kiranduriseti/HID_controller_PCB/STM32_HID_controller/bom-JLCPCB Assembly Order Final.xls

JLCPCB BOM Tool - BOM Matching
BOM name：bom-JLCPCB Assembly Order.xlsx |  |  | Download Time：2026-09-28 13:52:42 |  |  |  | * Our matching results are updated in real-time, but stock and prices may change. If it's been over 24 hours, please re-match before placing your order.
PCB Assembled Qty：5 |  |  | Est. Total Price：50.8586
Your BOM |  |  |  | Matched Parts |  |  |  |  |  |  | Order Information
Designator | Comment | Footprint | JLCPCB Part # | Matches | Part # | Manufacturer | Footprint | Description | Category | Warning | JLCPCB Part # | Product link | Lib Type | Qty | Source | Total Price ($)
C1,C10,C2,C22,C3,C4,C5,C7 | 100n | 0402 |  | Select by Customer | CL05B104KO5NNNC | Samsung Electro-Mechanics | 0402 | 100nF 16V X7R ±10% 0402 Multilayer Ceramic Capacitors MLCC - SMD/SMT ROHS | Multilayer Ceramic Capacitors MLCC - SMD/SMT | 1.The comment (CL05B104KO5NNNC) of this part does not match the one (100n) provided in your BOM. Please confirm; | C1525 | https://jlcpcb.com/partdetail/1877-CL05B104KO5NNNC/C1525 | Basic | 26 | 26 JLCPCB | 0.117
C6 | 10u | 0603 |  | Select by Customer | TCC0603X5R106K100CT | CCTC | 0603 | 10V 10uF X5R ±10% 0603 Multilayer Ceramic Capacitors MLCC - SMD/SMT ROHS | Multilayer Ceramic Capacitors MLCC - SMD/SMT | 1.The comment (TCC0603X5R106K100CT) of this part does not match the one (10u) provided in your BOM. Please confirm; | C380314 | https://jlcpcb.com/partdetail/CCTC-TCC0603X5R106K100CT/C380314 | Extended | 20 | 20 JLCPCB | 0.768
C8,C9 | 1u | 0402 |  | Select by Customer | CL05A105KA5NQNC | Samsung Electro-Mechanics | 0402 | 1uF 25V X5R ±10% 0402 Multilayer Ceramic Capacitors MLCC - SMD/SMT ROHS | Multilayer Ceramic Capacitors MLCC - SMD/SMT | 1.The comment (CL05A105KA5NQNC) of this part does not match the one (1u) provided in your BOM. Please confirm; | C52923 | https://jlcpcb.com/partdetail/53938-CL05A105KA5NQNC/C52923 | Basic | 20 | 20 JLCPCB | 0.198
C11,C12 | 10p | 0402 |  | Select by Customer | CL05C100JB5NNNC | Samsung Electro-Mechanics | 0402 | 10pF 50V C0G ±5% 0402 Multilayer Ceramic Capacitors MLCC - SMD/SMT ROHS | Multilayer Ceramic Capacitors MLCC - SMD/SMT | 1.The comment (CL05C100JB5NNNC) of this part does not match the one (10p) provided in your BOM. Please confirm; | C32949 | https://jlcpcb.com/partdetail/33914-CL05C100JB5NNNC/C32949 | Basic | 20 | 20 JLCPCB | 0.114
C13 | 22u | 0805 |  | Select by Customer | TCC0805X5R226K160FT | CCTC | 0805 | 16V 22uF ±10% 0805 Multilayer Ceramic Capacitors MLCC - SMD/SMT ROHS |  | 1.The comment (TCC0805X5R226K160FT) of this part does not match the one (22u) provided in your BOM. Please confirm; | C48885730 | https://jlcpcb.com/partdetail/CCTC-TCC0805X5R226K160FT/C48885730 | Extended | 6 | 6 JLCPCB | 0.7932
C14 | 10u | 0805 |  | Select by Customer | HGC0805R5106K250NSLJ | Chinocera | 0805 | 10uF 25V X5R ±10% 0805 Multilayer Ceramic Capacitors MLCC - SMD/SMT ROHS | Multilayer Ceramic Capacitors MLCC - SMD/SMT | 1.The comment (HGC0805R5106K250NSLJ) of this part does not match the one (10u) provided in your BOM. Please confirm; | C19103847 | https://jlcpcb.com/partdetail/Chinocera-HGC0805R5106K250NSLJ/C19103847 | Extended | 20 | 20 JLCPCB | 0.908
C15,C16,C17,C18,C23 | 10n | 0402 |  | Select by Customer | CL05B103KB5NNNC | Samsung Electro-Mechanics | 0402 | 10nF 50V X7R ±10% 0402 Multilayer Ceramic Capacitors MLCC - SMD/SMT ROHS | Multilayer Ceramic Capacitors MLCC - SMD/SMT | 1.The comment (CL05B103KB5NNNC) of this part does not match the one (10n) provided in your BOM. Please confirm; | C15195 | https://jlcpcb.com/partdetail/15869-CL05B103KB5NNNC/C15195 | Basic | 20 | 20 JLCPCB | 0.1
C21 | 4.7u | 0603 |  | Select by Customer | CL10A475KP8NNNC | Samsung Electro-Mechanics | 0603 | 10V 4.7uF X5R ±10% 0603 Multilayer Ceramic Capacitors MLCC - SMD/SMT ROHS | Multilayer Ceramic Capacitors MLCC - SMD/SMT | 1.The comment (CL10A475KP8NNNC) of this part does not match the one (4.7u) provided in your BOM. Please confirm; | C1705 | https://jlcpcb.com/partdetail/2057-CL10A475KP8NNNC/C1705 | Extended | 20 | 20 JLCPCB | 0.324
C24 | 2.2u | 0201 |  | Select by Customer | GRM033R60J225ME47D | Murata Electronics | 0201 | 2.2uF 6.3V X5R ±20% 0201 Multilayer Ceramic Capacitors MLCC - SMD/SMT ROHS | Multilayer Ceramic Capacitors MLCC - SMD/SMT | 1.The comment (GRM033R60J225ME47D) of this part does not match the one (2.2u) provided in your BOM. Please confirm; | C76933 | https://jlcpcb.com/partdetail/MurataElectronics-GRM033R60J225ME47D/C76933 | Extended | 20 | 20 JLCPCB | 0.54
D1 | RED | 0603 |  | Select by Customer | XL-1608SURC-06 | XINGLIGHT | 0603 | -40℃~+85℃ 120° 2.3V 20mA 225mcd 50mW 620nm~630nm 625nm Discrete Diode Red Top-mount Water Clear 0603 LED Indication - Discrete ROHS | LED Indication - Discrete |  | C965799 | https://jlcpcb.com/partdetail/XINGLIGHT-XL_1608SURC06/C965799 | Extended | 20 | 20 JLCPCB | 0.076
FB1 | 120R | 0603 |  | Select by Customer | BLM18AG121SN1D | Murata Electronics | 0603 | -55℃~+125℃ 1 120Ω@100MHz 180mΩ 800mA ±25% 0603 Ferrite Beads ROHS | Ferrite Beads |  | C76892 | https://jlcpcb.com/partdetail/MurataElectronics-BLM18AG121SN1D/C76892 | Extended | 20 | 20 JLCPCB | 0.25
J1 | USB_B_Micro | USB_Micro-B_Wuerth_629105150521 |  | Select by Customer | 629105150521 | Wurth Elektronik | SMD | -40℃~+85℃ 1 1A、3A 30V 5P Black Female Micro-B USB 2.0 SMD USB Connectors ROHS | USB Connectors |  | C2894326 | https://jlcpcb.com/partdetail/WurthElektronik-629105150521/C2894326 | Extended | 2 | 2 JLCPCB | 6.236
J2 | Conn_01x04_Pin | PinHeader_1x04_P2.54mm_Vertical |  | Select by Customer | PZ2.54-1x4-11.2 | ZHOURI | 插件,P=2.54mm | -45℃~+105℃ 1 1x4P 2.54mm 2.54mm 2.5A 3mm 4P 5.7mm Brass Gold Square pin Through Hole Plugin,P=2.54mm Pin Headers ROHS | Pin Headers |  | C29779969 | https://jlcpcb.com/partdetail/ZHOURI-PZ2_54_1x4_112/C29779969 | Extended | 3 | 3 JLCPCB | 0.0756
J3,J5 | Conn_01x03_Pin | JST_EH_S3B-EH_1x03_P2.50mm_Horizontal |  | Select by Customer | S3B-EH(LF)(SN) | JST | 弯插,P=2.5mm | -25℃~+85℃ 1 10mm 1x3P 2.5mm 250V 3 3A 3P 4.2mm 8.2mm Brass EH K Pin PA66 Right Angle Tin UL94V-0 White 弯插,P=2.5mm Wire To Board Connector ROHS | Wire To Board Connector |  | C263754 | https://jlcpcb.com/partdetail/JST-S3B_EH_LF_SN/C263754 | Extended | 5 | 5 JLCPCB | 0.282
R1 | 10k | 0402 |  | Select by Customer | RC0402FR-0710KL | YAGEO | 0402 | -55℃~+155℃ 10kΩ 50V 62.5mW Thick Film Resistor ±1% ±100ppm/℃ 0402 Chip Resistor - Surface Mount ROHS | Chip Resistor - Surface Mount | 1.The comment (RC0402FR-0710KL) of this part does not match the one (10k) provided in your BOM. Please confirm; | C60490 | https://jlcpcb.com/partdetail/YAGEO-RC0402FR0710KL/C60490 | Extended | 20 | 20 JLCPCB | 0.046
R2 | 1.5k | 0402 |  | Select by Customer | CRCW04021K50FKED | Vishay Intertech | 0402 | -55℃~+155℃ 1.5kΩ 63mW Thick Film Resistor ±1% ±100ppm/℃ 0402 Chip Resistor - Surface Mount ROHS | Others | 1.The comment (CRCW04021K50FKED) of this part does not match the one (1.5k) provided in your BOM. Please confirm; | C71622 | https://jlcpcb.com/partdetail/VishayIntertech-CRCW04021K50FKED/C71622 | Extended | 20 | 20 JLCPCB | 0.132
R3,R4 | 4.7k | 0402 |  | Select by Customer | SCR0402F4K7 | VO | 0402 | -55℃~+155℃ 4.7kΩ 50V 62.5mW Thick Film Resistor ±1% ±100ppm/℃ 0402 Chip Resistor - Surface Mount ROHS | Chip Resistor - Surface Mount | 1.The comment (SCR0402F4K7) of this part does not match the one (4.7k) provided in your BOM. Please confirm; | C3015810 | https://jlcpcb.com/partdetail/VO-SCR0402F4K7/C3015810 | Extended | 20 | 20 JLCPCB | 0.01
SW1 | SW_SPDT | SW_SPDT_PCM12 |  | Select by Customer | PCM12SMTR | C&K | SMD | -20℃~+85℃ 6V PC Pin Rectangular Columnar SPDT Surface Mount,Vertical SMD Slide Switches ROHS | Slide Switches |  | C221841 | https://jlcpcb.com/partdetail/CK-PCM12SMTR/C221841 | Extended | 2 | 2 JLCPCB | 3.563
SW6,SW7,SW8,SW9 | SW_Push | SW_PUSH-12mm_Wuerth-430476085716 |  | Select by Customer | B3F-4055 | Omron Electronics | 插件-4P,12x12mm | -25℃~+70℃ 1,000,000 cycles 12mm 12mm 2.6N 24V 50mA 7.3mm PC Pin Rectangular Button SPST-NO Through Hole 插件-4P,12x12mm Tactile Switches ROHS | Tactile Switches |  | C84931 | https://jlcpcb.com/partdetail/OmronElectronics-B3F4055/C84931 | Extended | 8 | 8 JLCPCB | 1.0264
SW10,SW11,SW14,SW2,SW3 | SW_Push | SW_PUSH_6mm |  | Select by Customer | B3F-1000 | Omron Electronics | 插件-4P,6x6mm | -25℃~+70℃ 1,000,000 cycles 1N 24V 4.3mm 50mA 6mm 6mm PC Pin Round Button SPST-NO Through Hole 插件-4P,6x6mm Tactile Switches ROHS | Tactile Switches |  | C93157 | https://jlcpcb.com/partdetail/OmronElectronics-B3F1000/C93157 | Extended | 11 | 11 JLCPCB | 1.8832
U1 | STM32F446RETx | LQFP-64_10x10mm_P0.5mm |  | Select by Customer | STM32F446RET6 | STMicroelectronics | LQFP-64(10x10) | -40℃~+85℃ 1.7V~3.6V 128KB 12bit 12bit 180MHz 32 Bit 50 512KB ARM Cortex-M4 Built-in FLASH LQFP-64(10x10) Microcontrollers (MCU/MPU/SOC) ROHS | Microcontrollers (MCU/MPU/SOC) |  | C69336 | https://jlcpcb.com/partdetail/STMicroelectronics-STM32F446RET6/C69336 | Extended | 2 | 2 JLCPCB | 24.6806
U2 | TLV1117-33 | SOT-223-3_TabPin2 |  | Select by Customer | TLV1117LV33DCYR | Texas Instruments | SOT-223 | -40℃~+125℃@(Tj) 1 100uA 1A 3.3V 455mV@(1A) 5.5V 60uVrms 65dB@(1kHz) Fixed Positive Under Voltage Lockout、Over Current Protection、Over Temperature Protection SOT-223 Voltage Regulators - Linear, Low Drop Out (LDO) Regulators ROHS | Voltage Regulators - Linear, Low Drop Out (LDO) Regulators |  | C15578 | https://jlcpcb.com/partdetail/TexasInstruments-TLV1117LV33DCYR/C15578 | Extended | 5 | 5 JLCPCB | 1.965
U3 | USBLC6-2SC6 | SOT-23-6 |  | Select by Customer | USBLC6-2SC6 | STMicroelectronics | SOT-23-6L | -40℃~+125℃ 150nA 17V 2 3.5pF 5.25V 5A 6V ESD IEC 61000-4-2 Unidirectional SOT-23-6L ESD and Surge Protection (TVS/ESD) ROHS | ESD And Surge Protection (TVS/ESD) |  | C7519 | https://jlcpcb.com/partdetail/STMicroelectronics-USBLC62SC6/C7519 | Extended | 5 | 5 JLCPCB | 0.8825
U4 | joystick_right | XDCR_COM-09032 |  | Select by Customer | RKJXV1224005 | ALPSALPINE | 插件,13x13mm | 插件,13x13mm Multi-Directional Switches ROHS | Multi-Directional Switches | 1.Multiple lines in the BOM have been matched to the same part. Please check if the matching is correct. ; | C146170 | https://jlcpcb.com/partdetail/ALPSALPINE-RKJXV1224005/C146170 | Extended | 0 | 0 JLCPCB | 0
U5 | joystick_left | XDCR_COM-09032 |  | Select by Customer | RKJXV1224005 | ALPSALPINE | 插件,13x13mm | 插件,13x13mm Multi-Directional Switches ROHS | Multi-Directional Switches | 1.Multiple lines in the BOM have been matched to the same part. Please check if the matching is correct. ; | C146170 | https://jlcpcb.com/partdetail/ALPSALPINE-RKJXV1224005/C146170 | Extended | 0 | 0 JLCPCB | 0
U7 | ICM-42670-P | LGA14_2.5X3X0.76_IVS-M |  | Select by Customer | ICM-42670-P | TDK InvenSense | LGA-14(2.5x3) | -40℃~+85℃ 1.71V~3.6V 16bit 2.25KB 3.5uA Accelerometer Gyroscope SPI、I2C、I3C X,Y,Z X,Y,Z ±16g ±2000dps LGA-14(2.5x3) Accelerometers ROHS | Accelerometers |  | C3288646 | https://jlcpcb.com/partdetail/TDKInvenSense-ICM_42670P/C3288646 | Extended | 2 | 2 JLCPCB | 4.5536
Y1 | 8MHz | Crystal_SMD_3225-4Pin_3.2x2.5mm |  | Select by Customer | 3225-8.00-8-10-10/A | Suzhou Liming Elec | SMD3225-4P | -20℃~+70℃ 8MHz 8pF Crystal Oscillator ±10ppm ±20ppm SMD3225-4P Crystals ROHS | Crystals |  | C518135 | https://jlcpcb.com/partdetail/534672-3225_8_00_8_10_10A/C518135 | Extended | 5 | 5 JLCPCB | 1.3345
