kiranduriseti/HID_controller_PCB/STM32_HID_controller_shoulder/bom-JLCPCB Assembly Order Final.xls

JLCPCB BOM Tool - BOM Matching
BOM name：bom-JLCPCB Assembly Order.xlsx |  |  | Download Time：2026-09-28 14:10:01 |  |  |  | * Our matching results are updated in real-time, but stock and prices may change. If it's been over 24 hours, please re-match before placing your order.
PCB Assembled Qty：5 |  |  | Est. Total Price：1.3828
Your BOM |  |  |  | Matched Parts |  |  |  |  |  |  | Order Information
Designator | Comment | Footprint | JLCPCB Part # | Matches | Part # | Manufacturer | Footprint | Description | Category | Warning | JLCPCB Part # | Product link | Lib Type | Qty | Source | Total Price ($)
J4 | Conn_01x03_Socket | JST_EH_S3B-EH_1x03_P2.50mm_Horizontal |  | Select by Customer | S3B-EH(LF)(SN) | JST | 弯插,P=2.5mm | -25℃~+85℃ 1 10mm 1x3P 2.5mm 250V 3 3A 3P 4.2mm 8.2mm Brass EH K Pin PA66 Right Angle Tin UL94V-0 White 弯插,P=2.5mm Wire To Board Connector ROHS | Wire To Board Connector |  | C263754 | https://jlcpcb.com/partdetail/JST-S3B_EH_LF_SN/C263754 | Extended | 3 | 3 JLCPCB | 0.1692
SHOULDER1 | SW_Push | SW_PUSH-12mm_Wuerth-430476085716 |  | Select by Customer | B3F-4055 | Omron Electronics | 插件-4P,12x12mm | -25℃~+70℃ 1,000,000 cycles 12mm 12mm 2.6N 24V 50mA 7.3mm PC Pin Rectangular Button SPST-NO Through Hole 插件-4P,12x12mm Tactile Switches ROHS | Tactile Switches |  | C84931 | https://jlcpcb.com/partdetail/OmronElectronics-B3F4055/C84931 | Extended | 2 | 2 JLCPCB | 0.2566
TRIGGER1 | SW_Push | SW_DIP_SPSTx01_Piano_10.8x4.1mm_W7.62mm_P2.54mm |  | Select by Customer | DS1040-01RT | CONNFLY Elec | 插件,P=2.54mm | -40℃~+85℃ 1 2.54mm PC Pin Red SPST 插件,P=2.54mm DIP Switches ROHS | DIP Switches |  | C3024979 | https://jlcpcb.com/partdetail/CONNFLYElec-DS104001RT/C3024979 | Extended | 3 | 3 JLCPCB | 0.957
