kiranduriseti/HID_controller_PCB/STM32_HID_controller_shoulder/production/bom.csv

Designator | Footprint | Quantity | Value | LCSC Part #
J4 | JST_EH_S3B-EH_1x03_P2.50mm_Horizontal | 1 | Conn_01x03_Socket
SHOULDER1 | SW_PUSH-12mm_Wuerth-430476085716 | 1 | SW_Push
TRIGGER1 | SW_DIP_SPSTx01_Piano_10.8x4.1mm_W7.62mm_P2.54mm | 1 | SW_Push
