kiranduriseti/HID_controller_PCB/STM32_HID_controller_shoulder/ADXL345/ADXL345.step

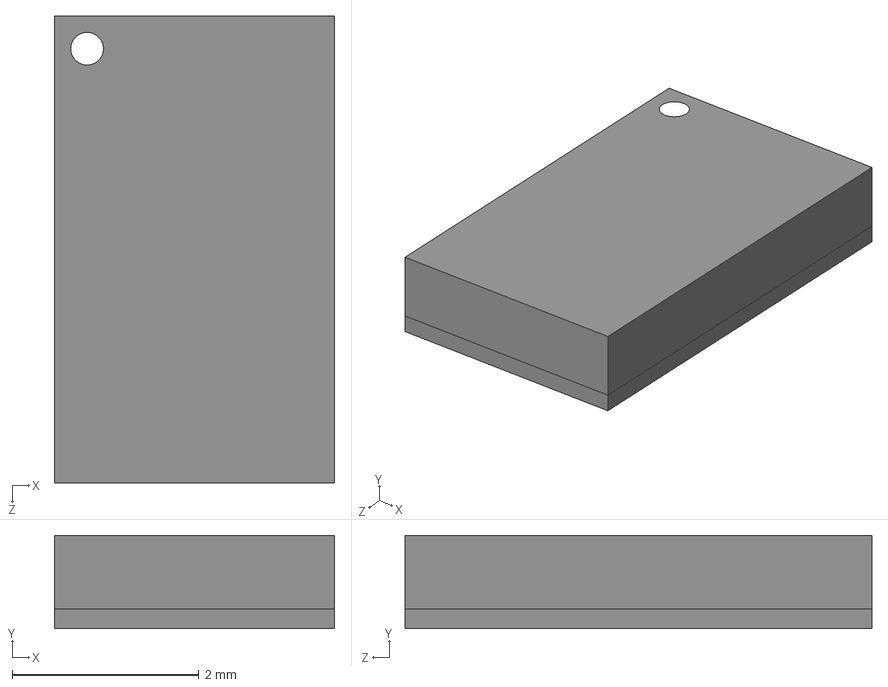
[picture p1: CAD file, 2026-01-08]
STM32_HID_controller_shoulder/ADXL345/ADXL345.step
3.00 x 1.00 x 5.00 mm
