kiranduriseti/HID_controller_PCB/STM32_HID_controller_shoulder/COM-09032/COM-09032.step

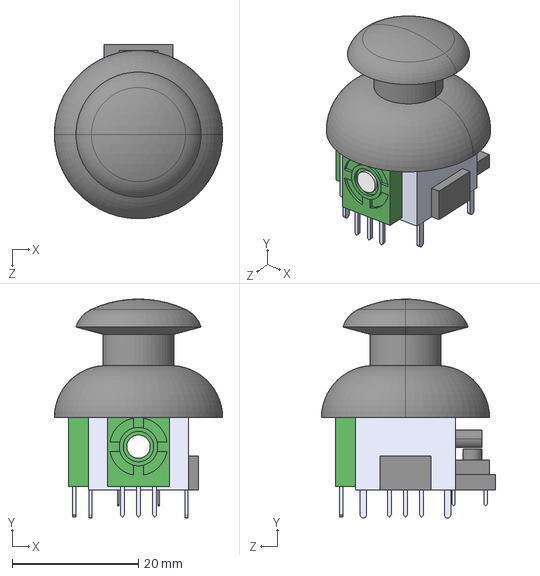
[picture p2: CAD file, 2026-01-08]
STM32_HID_controller_shoulder/COM-09032/COM-09032.step
26.7 x 34.7 x 27.6 mm
