kiranduriseti/HID_controller_PCB/STM32_HID_controller_shoulder/629105150521%20%28rev1%29.stp

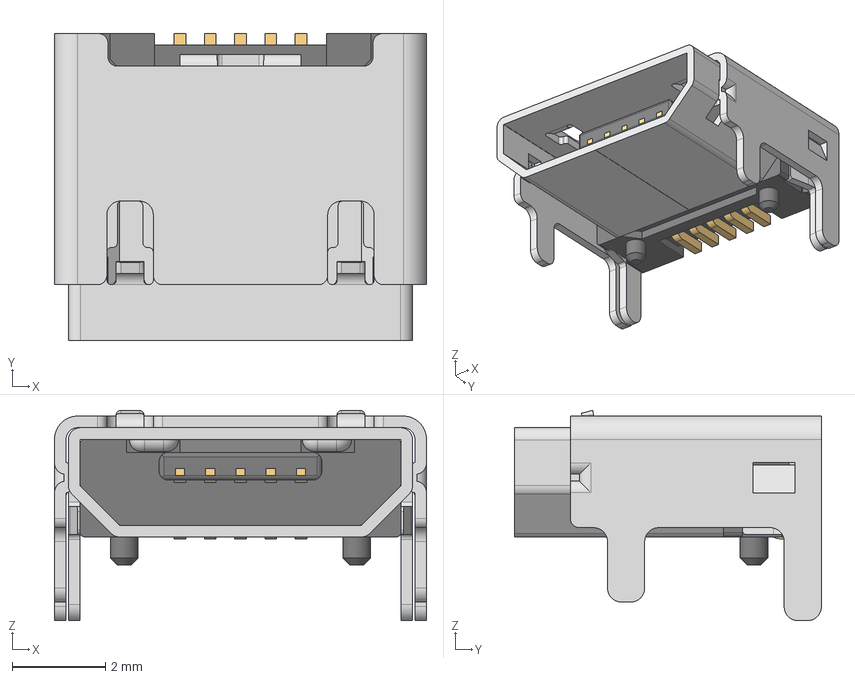
[picture p3: CAD file, 2026-01-08]
STM32_HID_controller_shoulder/629105150521%20%28rev1%29.stp
8.00 x 6.60 x 4.52 mm
629105150521_Housing
629105150521_Pin1 x 4
629105150521_Pin2
629105150521_Shielding2
629105150521_Shielding
