kiranduriseti/HID_controller_PCB/STM32_HID_controller_shoulder/STM32_HID_controller-right.kicad_pcb

## KiCad design STM32_HID_controller_shoulder/STM32_HID_controller-right.kicad_pcb (2026-09-28)

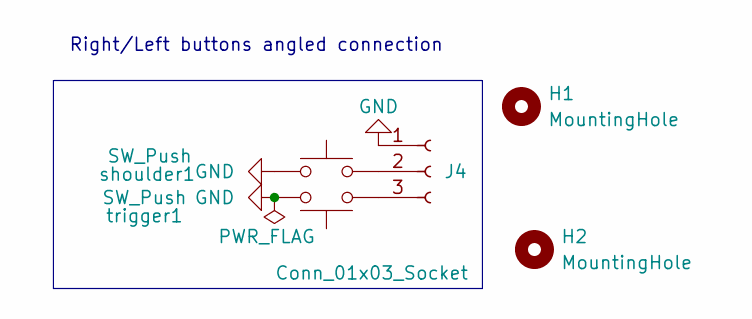
[picture p4: schematic STM32_HID_controller-right.kicad_sch, STM32 HID Controller PCB]

Parts:
H1, H2: MountingHole; MountingHole_2.2mm_M2
J4: Conn_01x03_Socket; JST_EH_S3B-EH_1x03_P2.50mm_Horizontal
shoulder1: SW_Push; SW_PUSH-12mm_Wuerth-430476085716
trigger1: SW_Push; SW_DIP_SPSTx01_Piano_10.8x4.1mm_W7.62mm_P2.54mm

Connections:
GND: J4.1, shoulder1.2, trigger1.1
unnamed: J4.2, shoulder1.1
unnamed: J4.3, trigger1.2

Notes on the sheet:
Right/Left buttons angled connection

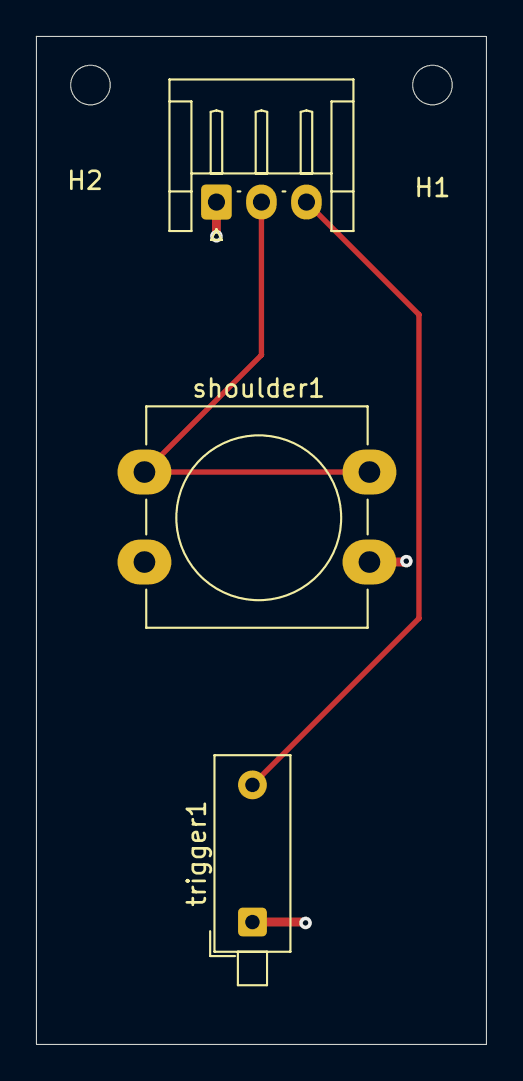
[picture p5: board STM32_HID_controller-right.kicad_pcb from above]

Board: 2 copper layers, 25.0 x 56.0 mm, 5 parts (0 on the bottom side), 3 nets.
