kiranduriseti/HID_controller_PCB/STM32_HID_controller/STM32_HID_controller.kicad_pcb

## KiCad design STM32_HID_controller/STM32_HID_controller.kicad_pcb (2026-09-28)

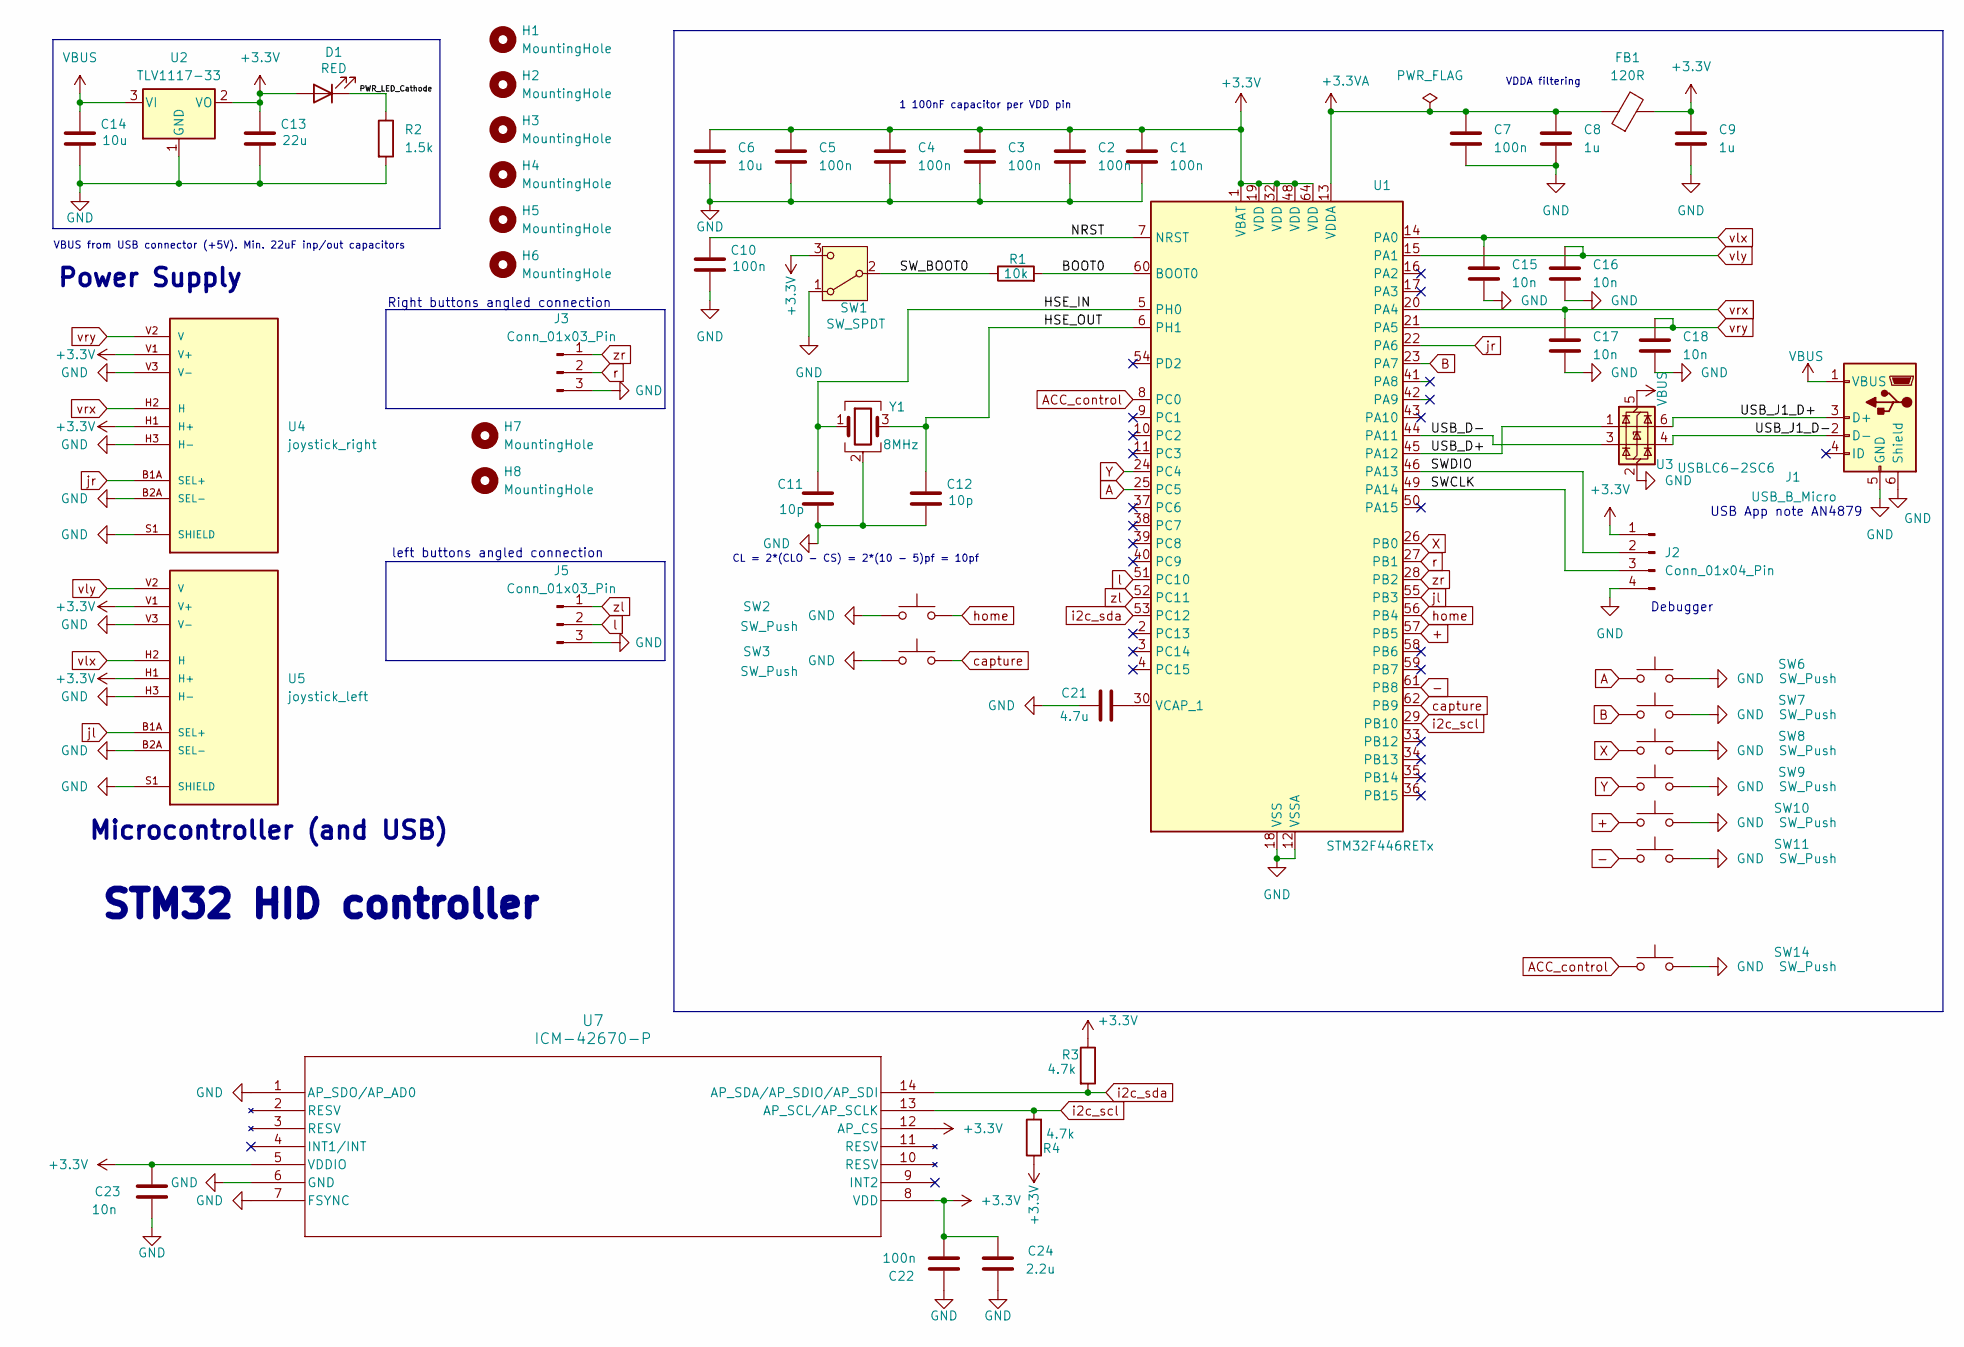
[picture p6: schematic STM32_HID_controller.kicad_sch, STM32 HID Controller PCB]

Parts:
C1, C2, C3, C4, C5, C7, C10, C22: 100n; C_0402_1005Metric; MPN GRM155R71C104KA88D
C6: 10u; C_0603_1608Metric; MPN C1608X5R1A106K080AC
C8, C9: 1u; C_0402_1005Metric; MPN CC0402KRX5R6BB105
C11, C12: 10p; C_0402_1005Metric; MPN GRM1555C1H100JA01D
C13: 22u; C_0805_2012Metric; MPN C0805C226M8PACTU
C14: 10u; C_0805_2012Metric; MPN C0805C106M8PACTU
C15, C16, C17, C18, C23: 10n; C_0402_1005Metric; MPN GRM155R71C103KA01D
C21: 4.7u; C_0603_1608Metric; MPN C0603C475K8PACTU
C24: 2.2u; C_0201_0603Metric; MPN GRM033R60J225ME47D
D1: RED; LED_0603_1608Metric; MPN LTST-C190KRKT
FB1: 120R; L_0603_1608Metric; MPN BLM18AG121SN1D
H1, H3, H7, H8: MountingHole; MountingHole_2.2mm_M2
H2, H4, H5, H6: MountingHole; MountingHole_3.2mm_M3
J1: USB_B_Micro; USB_Micro-B_Wuerth_629105150521; MPN 629105150521
J2: Conn_01x04_Pin; PinHeader_1x04_P2.54mm_Vertical; MPN 61300411121
J3, J5: Conn_01x03_Pin; JST_EH_S3B-EH_1x03_P2.50mm_Horizontal; MPN S3B-EH(LF)(SN)
R1: 10k; R_0402_1005Metric; MPN RC0402FR-0710KL
R2: 1.5k; R_0402_1005Metric; MPN RC0402FR-071K5L
R3, R4: 4.7k; R_0402_1005Metric; MPN RC0402FR-074K7L
SW1: SW_SPDT; SW_SPDT_PCM12; MPN PCM12SMTR
SW2, SW3, SW10, SW11, SW14: SW_Push; SW_PUSH_6mm; MPN B3F-1000
SW6, SW7, SW8, SW9: SW_Push; SW_PUSH-12mm_Wuerth-430476085716; MPN 430476085716
U1: STM32F446RETx; LQFP-64_10x10mm_P0.5mm; MPN STM32F446RET6
U2: TLV1117-33; SOT-223-3_TabPin2; MPN TLV1117LV33DCYR
U3: USBLC6-2SC6; SOT-23-6; MPN USBLC6-2SC6
U4: joystick_right; XDCR_COM-09032; PARTREV N/A
U5: joystick_left; XDCR_COM-09032; PARTREV N/A
U7: ICM-42670-P; LGA14_2.5X3X0.76_IVS-M; MPN ICM-42670-P
Y1: 8MHz; Crystal_SMD_3225-4Pin_3.2x2.5mm; MPN J32SMX-H-F-G-I-8M0

Connections:
+: SW10.1, U1.57 (PB5)
+3.3V: C1.1, C2.1, C3.1, C4.1, C5.1, C6.1, C9.1, C13.1, C22.2, C23.2, C24.1, D1.2 (A), FB1.2, J2.1, R3.1, R4.1, SW1.3 (C), U1.1 (VBAT), U1.19 (VDD), U1.32 (VDD), U1.48 (VDD), U1.64 (VDD), U2.2 (VO), U4.H1 (H+), U4.V1 (V+), U5.H1 (H+), U5.V1 (V+), U7.5 (VDDIO), U7.8 (VDD), U7.12 (AP_CS)
+3.3VA: C7.1, C8.1, FB1.1, U1.13 (VDDA)
-: SW11.1, U1.61 (PB8)
/BOOT0: R1.2, U1.60 (BOOT0)
/HSE_IN: C11.1, U1.5 (PH0), Y1.1
/HSE_OUT: C12.1, U1.6 (PH1), Y1.3
/NRST: C10.1, U1.7 (NRST)
/PWR_LED_Cathode: D1.1 (K), R2.1
/SWCLK: J2.3, U1.49 (PA14)
/SWDIO: J2.2, U1.46 (PA13)
/SW_BOOT0: R1.1, SW1.2 (B)
/USB_D+: U1.45 (PA12), U3.1 (I/O1)
/USB_D-: U1.44 (PA11), U3.3 (I/O2)
/USB_J1_D+: J1.3 (D+), U3.6 (I/O1)
/USB_J1_D-: J1.2 (D-), U3.4 (I/O2)
A: SW6.1, U1.25 (PC5)
ACC_control: SW14.1, U1.8 (PC0)
B: SW7.1, U1.23 (PA7)
GND: C1.2, C2.2, C3.2, C4.2, C5.2, C6.2, C7.2, C8.2, C9.2, C10.2, C11.2, C12.2, C13.2, C14.2, C15.2, C16.2, C17.2, C18.2, C21.1, C22.1, C23.1, C24.2, J1.5 (GND), J1.6 (Shield), J2.4, J3.3, J5.3, R2.2, SW1.1 (A), SW2.1, SW3.1, SW6.2, SW7.2, SW8.2, SW9.2, SW10.2, SW11.2, SW14.2, U1.12 (VSSA), U1.18 (VSS), U1.31 (VSS), U1.47 (VSS), U1.63 (VSS), U2.1 (GND), U3.2 (GND), U4.B2A (SEL-), U4.H3 (H-), U4.S1 (SHIELD), U4.S2 (SHIELD), U4.S3 (SHIELD), U4.S4 (SHIELD), U4.V3 (V-), U5.B2A (SEL-), U5.H3 (H-), U5.S1 (SHIELD), U5.S2 (SHIELD), U5.S3 (SHIELD), U5.S4 (SHIELD), U5.V3 (V-), U7.1 (AP_SDO/AP_AD0), U7.6 (GND), U7.7 (FSYNC), Y1.2 (G), Y1.4 (G)
unnamed: C21.2, U1.30 (VCAP_1)
VBUS: C14.1, J1.1 (VBUS), U2.3 (VI), U3.5 (VBUS)
X: SW8.1, U1.26 (PB0)
Y: SW9.1, U1.24 (PC4)
capture: SW3.2, U1.62 (PB9)
home: SW2.2, U1.56 (PB4)
i2c_scl: R4.2, U1.29 (PB10), U7.13 (AP_SCL/AP_SCLK)
i2c_sda: R3.2, U1.53 (PC12), U7.14 (AP_SDA/AP_SDIO/AP_SDI)
jl: U1.55 (PB3), U5.B1A (SEL+)
jr: U1.22 (PA6), U4.B1A (SEL+)
l: J5.2, U1.51 (PC10)
r: J3.2, U1.27 (PB1)
vlx: C15.1, U1.14 (PA0), U5.H2 (H)
vly: C16.1, U1.15 (PA1), U5.V2 (V)
vrx: C17.1, U1.20 (PA4), U4.H2 (H)
vry: C18.1, U1.21 (PA5), U4.V2 (V)
zl: J5.1, U1.52 (PC11)
zr: J3.1, U1.28 (PB2)

Notes on the sheet:
1 100nF capacitor per VDD pin
VDDA filtering
Debugger
Microcontroller (and USB)
Power Supply
CL = 2*(CLO - CS) = 2*(10 - 5)pf = 10pf
USB App note AN4879
left buttons angled connection
Right buttons angled connection
STM32 HID controller
VBUS from USB connector (+5V). Min. 22uF inp/out capacitors

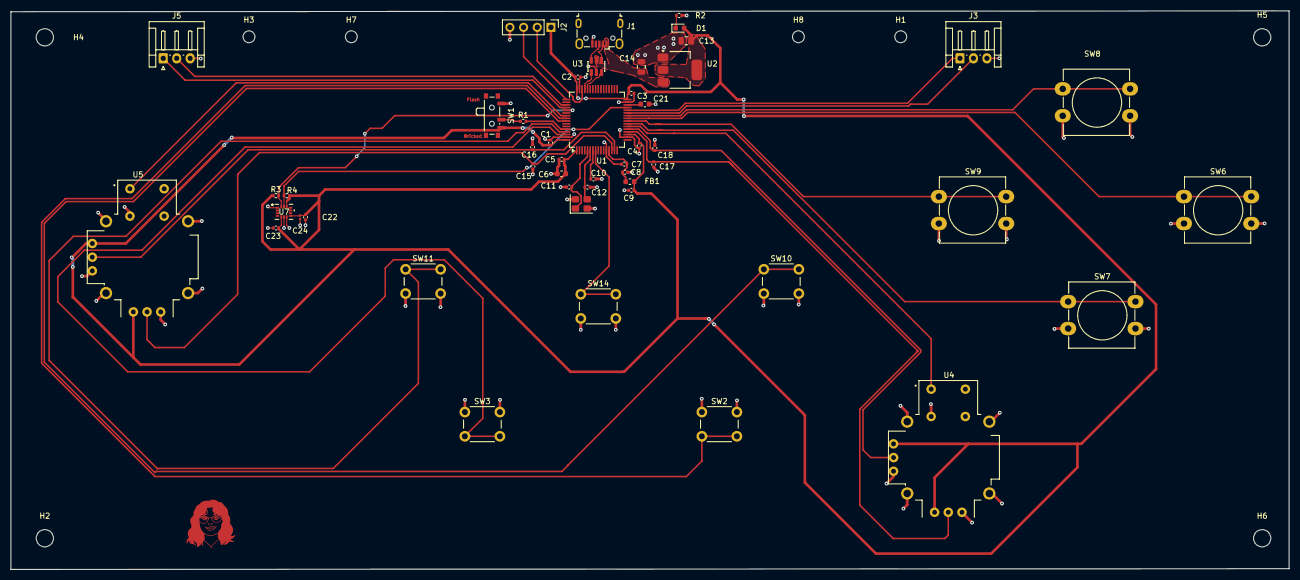
[picture p7: board STM32_HID_controller.kicad_pcb from above]

Board: 2 copper layers, 237.3 x 103.7 mm, 57 parts (0 on the bottom side), 38 nets.
