kiranduriseti/HID_controller_PCB/(commit log)

2026-01-08 Seperated PCBs
    [629105150521%20%28rev1%29.stp, ADXL345.STEP, ADXL345.step, COM-09032--3DModel-STEP-56544.STEP, COM-09032.step, STM32_HID_controller.kicad_pcb, STM32_HID_controller.kicad_sch]
2026-01-08 Started flux
    [STM32_HID_controller.kicad_pcb]
2026-01-09 Started flux for left and right
    [STM32_HID_controller.kicad_pcb, STM32_HID_controller.kicad_sch]
2026-01-09 added gnd vias shortend sclk
    [STM32_HID_controller.kicad_pcb]
2026-01-10 main pcb finished
    [STM32_HID_controller.kicad_pcb]
2026-01-10 Shoulder finished
    [629105150521%20%28rev1%29.stp, ADXL345.STEP, ADXL345.step, COM-09032--3DModel-STEP-56544.STEP, COM-09032.step, STM32_HID_controller-right.kicad_pcb, STM32_HID_controller-right.kicad_sch]
2026-01-10 final draft
    [STM32_HID_controller.kicad_pcb, STM32_HID_controller.kicad_sch]
2026-01-10 changed shoulder to right orientation
    [STM32_HID_controller-right.kicad_pcb, STM32_HID_controller-right.kicad_sch]
2026-01-10 changed 3.3V mapping
    [STM32_HID_controller.kicad_pcb]
2026-01-10 added text
    [STM32_HID_controller.kicad_pcb]
2026-01-10 changed 3.3V routing
    [STM32_HID_controller.kicad_pcb]
2026-01-16 added mpu
    [STM32_HID_controller.kicad_sch]
2026-01-17 mpu6050 pull ups
    [STM32_HID_controller.kicad_sch]
2026-01-17 added mpu to everything, final draft before review
    [STM32_HID_controller.kicad_pcb, STM32_HID_controller.kicad_sch]
2026-09-27 updated for switch config
    [STM32_HID_controller.kicad_pcb, STM32_HID_controller.kicad_sch]
2026-09-28 Switch prototype completed
    [BOM_JLCPCB.csv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]
2026-09-28 Switch prototype completed. Minor recheck
    [STM32_HID_controller-right.kicad_pcb, STM32_HID_controller.kicad_pcb]
